illusion8064/analog-kickdrum/hardware/assembled-circuit/full-ckt-breadboard.jpeg

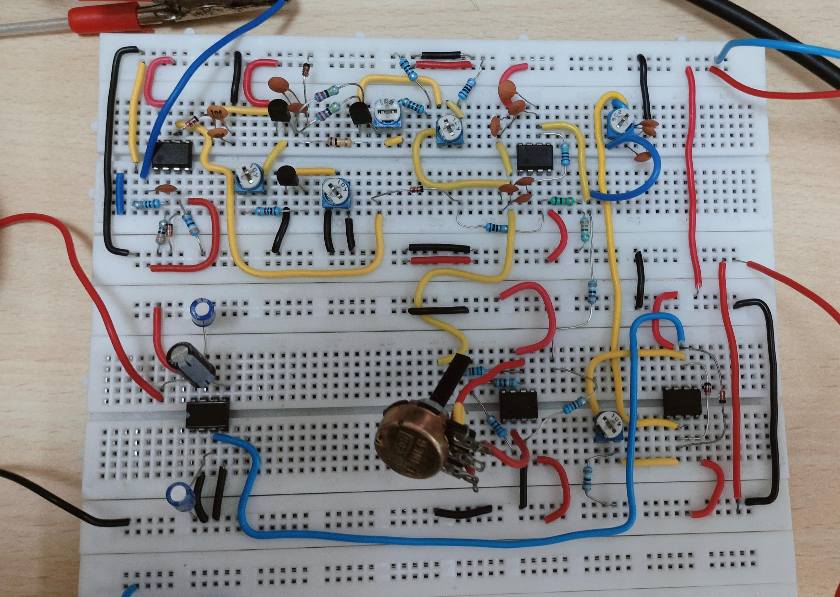
hardware/assembled-circuit/full-ckt-breadboard.jpeg
