illusion8064/analog-kickdrum/hardware/assembled-circuit/envelope.jpeg

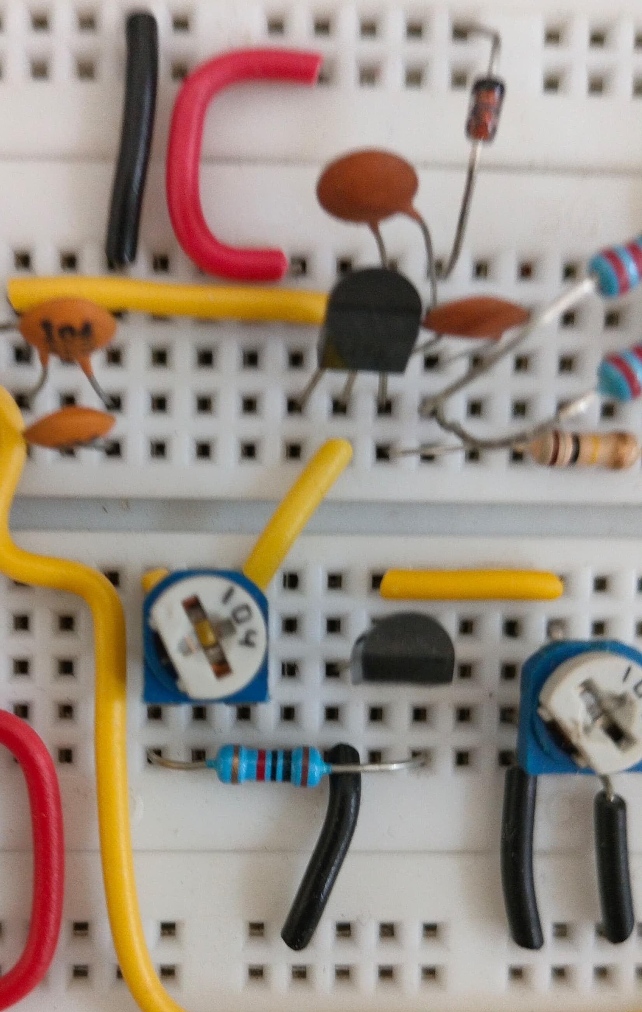
hardware/assembled-circuit/envelope.jpeg
