illusion8064/analog-kickdrum/documents/brief-presentation.pdf

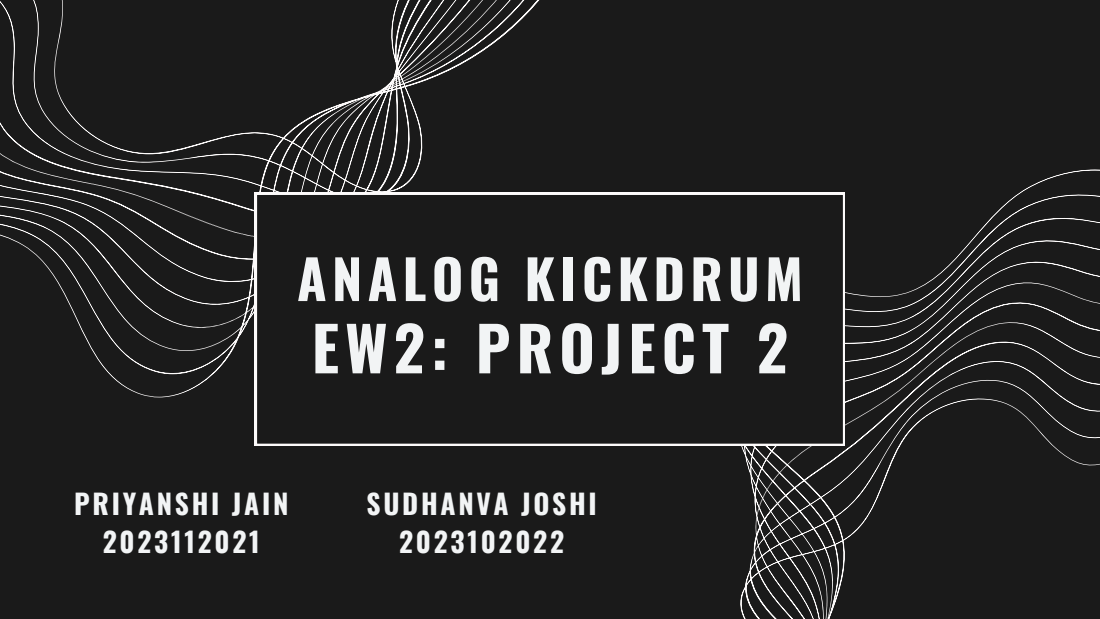
[picture p3: page 1]
EW2: PROJECT 2; ANALOG KICKDRUM; PRIYANSHI JAIN 2023112021; SUDHANVA JOSHI 2023102022

# STAGES

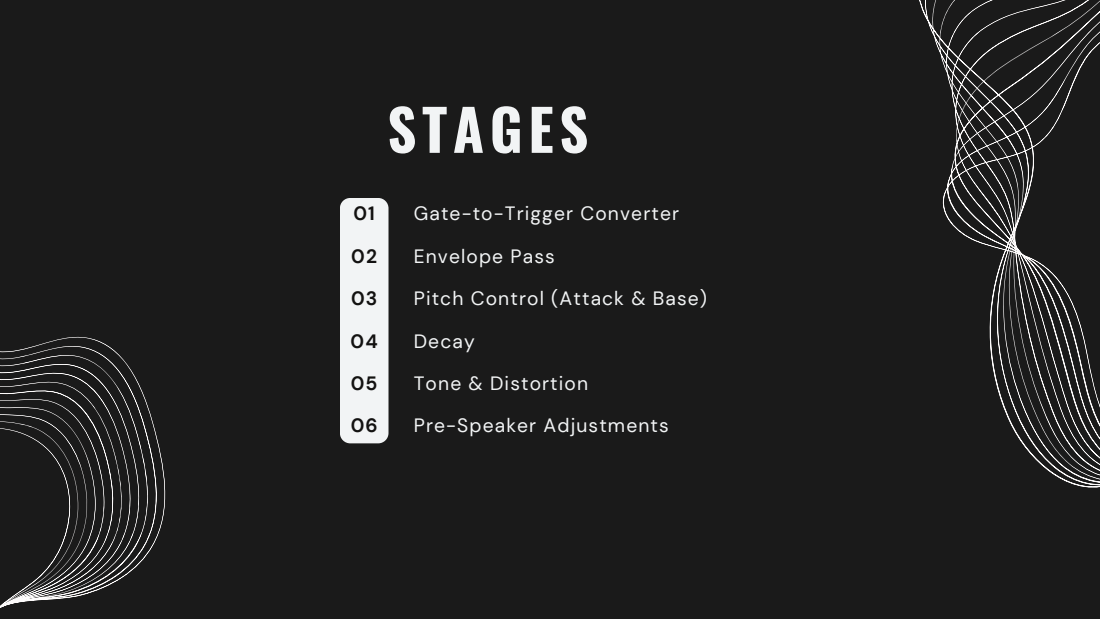
[picture p4: page 2]
Gate-to-Trigger Converter; Envelope Pass; Pitch Control (Attack & Base); Decay; Tone & Distortion; Pre-Speaker Adjustments

# GATE TO TRIGGER CONVERTER

An initial square wave is used to create a
sharp impulse, which will trigger a decaying sinusoid wave for our kickdrum.

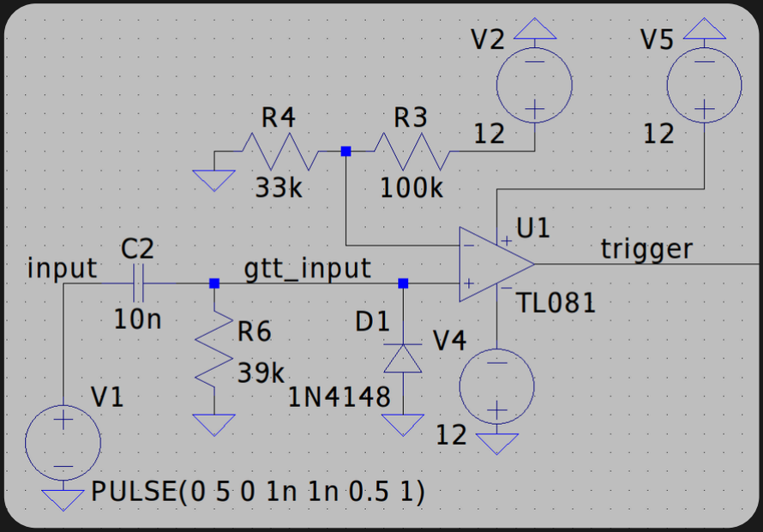
[picture p5: figure]

To only consider the positive impulses formed, we use a comparator which eliminates negative impulses.

As the base voltage of positive impulses is set at -12V, a diode is used to bring it back to set the favourable base voltage of 0V.

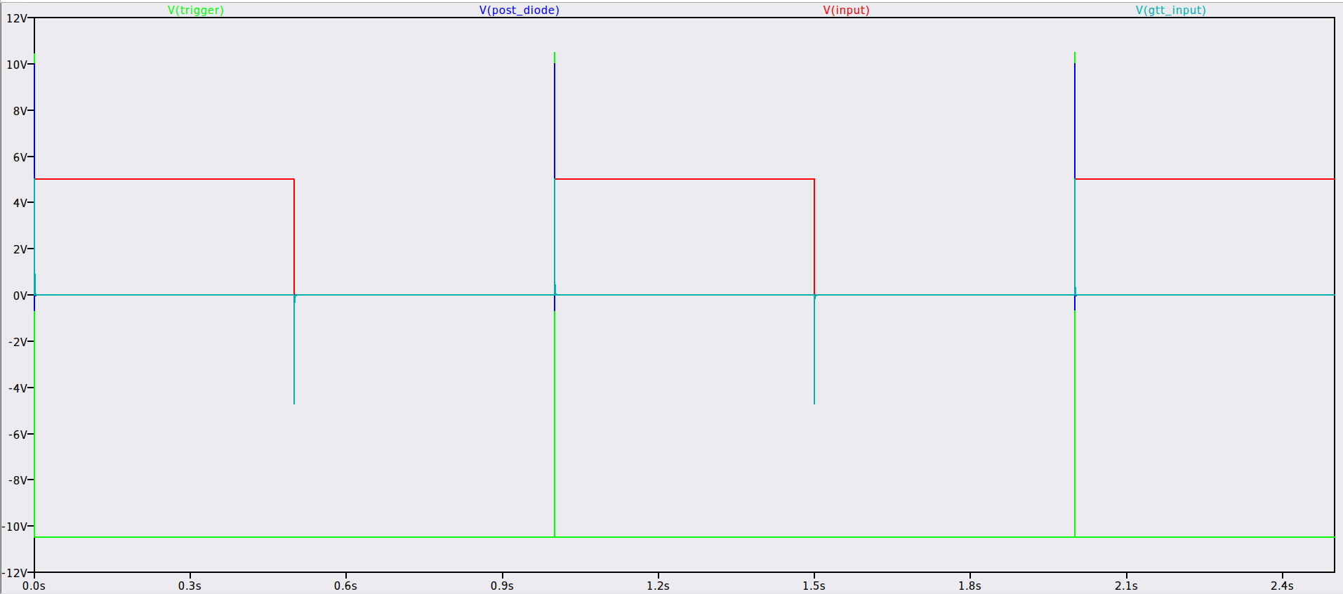
[picture p6: page 4]

# ENVELOPE STAGE

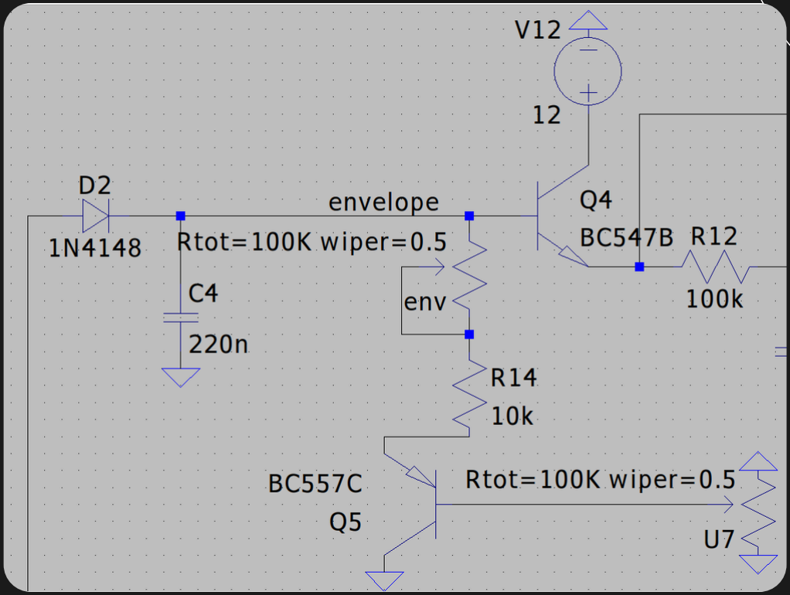
[picture p7: figure]

The envelope controls initial amplitude of our beat wave. This is also used to manipulate attack pitch in later stages.

We induce voltage discharge through a grounded capacitor, and allow rate control using a potentiometer and voltage (grounded and buffered currently).

An NPN BJT is used as a makeshift buffer instead of a bulky op-amp based buffer to prevent discharge path into other stages.

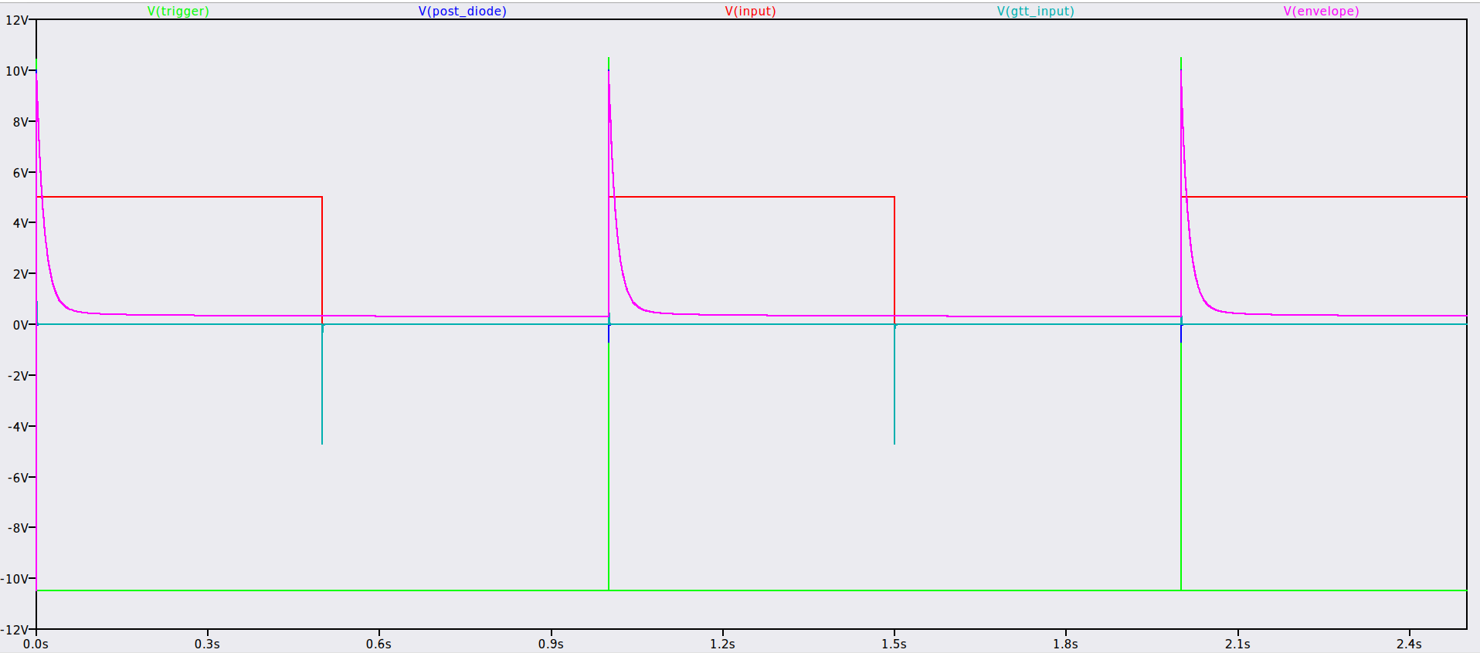
[picture p8: page 6]

# PITCH: BRIDGED-T OSCILLATOR

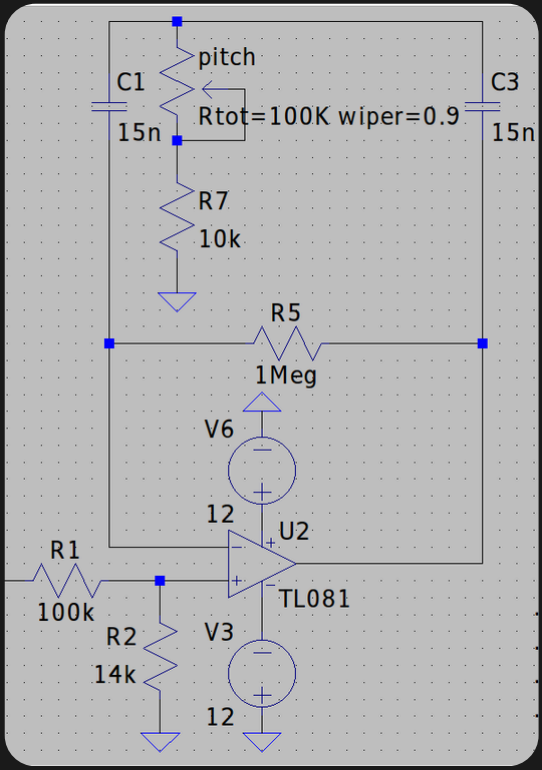
[picture p9: figure]

Pitch affects the frequency of our wave. We
get control over base pitch (f | ) and attack
pitch (f | ).

b a s e

i n iti a l

Initial Voltage Divider drops voltage level for op-amp reception, while potentiometer gives control over capacitor discharge rate.

The Bridge Resistor provides reverse current to the op-amp’s negative feedback for proper amplification, giving a decaying sinusoid.

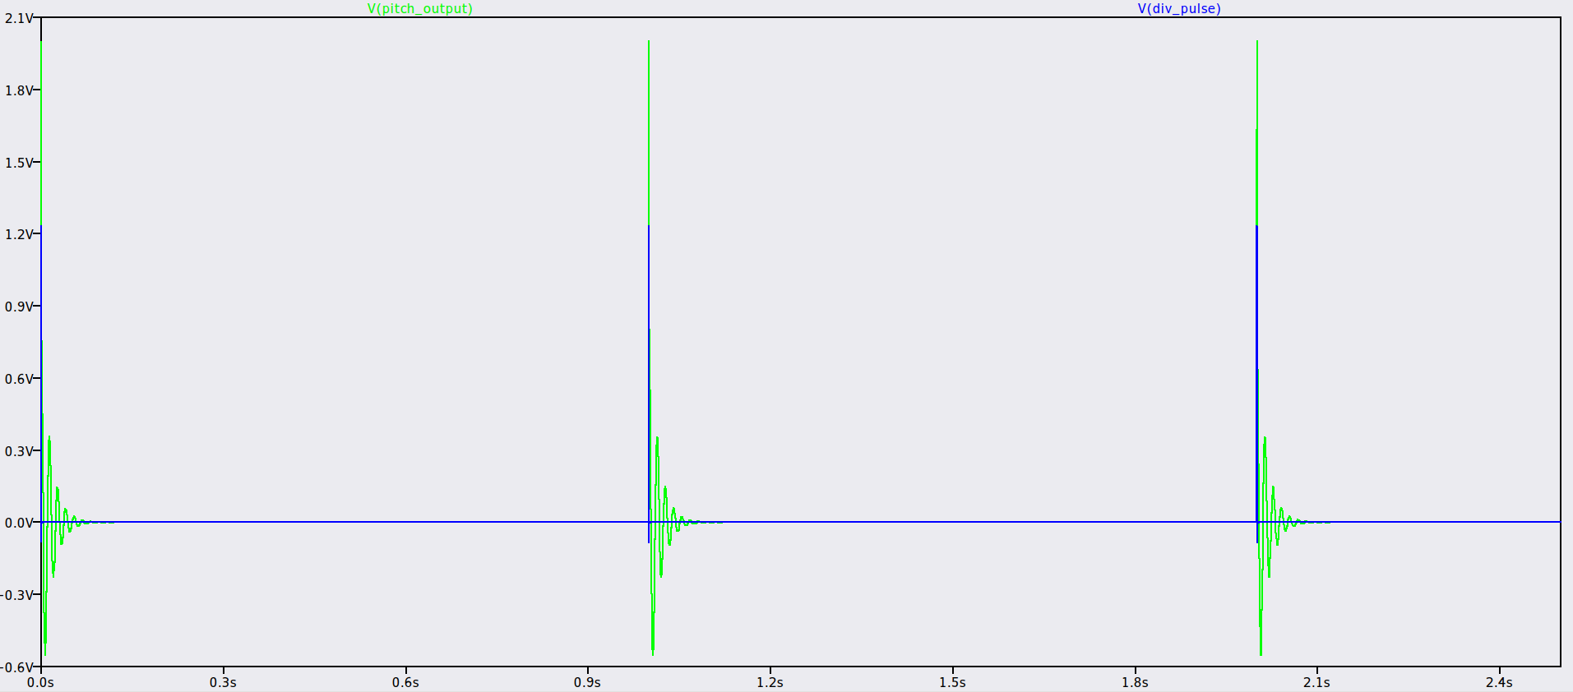
[picture p10: page 8]

# DECAY STAGE

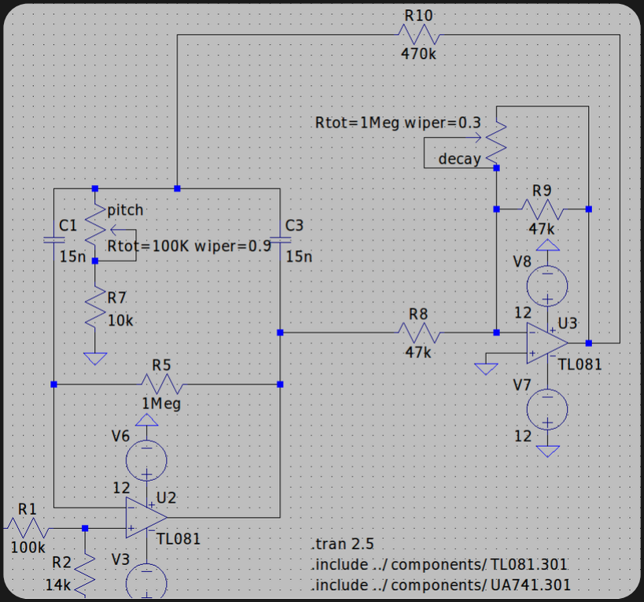
[picture p11: figure]

Decay controls the rate at which our sinusoid dies out.

Initial Voltage Divider drops voltage level for op-amp reception, while potentiometer gives control over capacitor discharge rate.

The Bridge Resistor provides reverse current to the op-amp’s negative feedback for proper amplification, giving a decaying sinuoid.

# TONE & DISTORTION

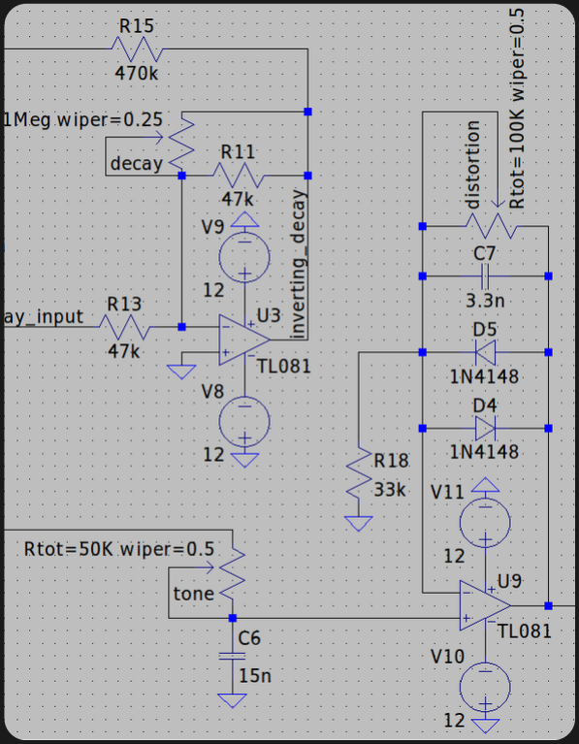
[picture p12: figure]

Tone manipulates the initial amplitude of our waveform, while distortion induces clipping & imperfection in the sinusoid.

An active distortion is induced by pairing 2 diodes, causing clipping and discharging to be controlled by a 100K potentiometer.

Amplitude is controlled using a potentiometer as a variable RC filter.

# FINAL STAGE; LM386 & SPEAKER

Using an LM386N to power our 4Ω speaker, we use a basic op-amp amplifier to attenuate our signal for working around the ±1V cutoff input voltage.

The gain achieved by LM386N is around 20, but the speaker’s impedance reduces voltage peak to favourable levels.

# THANK YOU

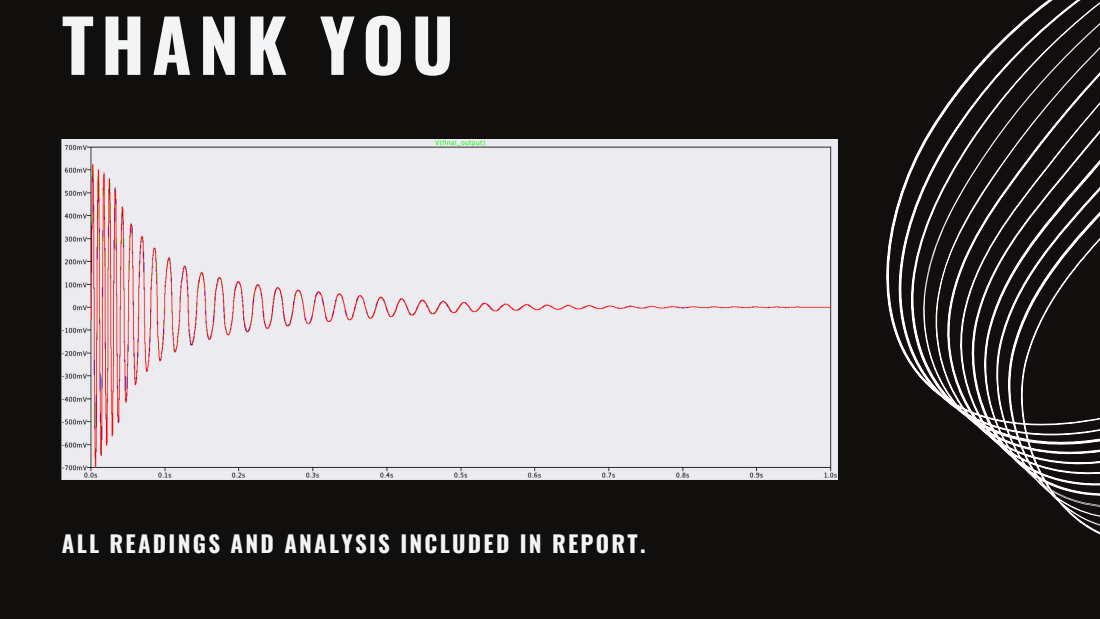
[picture p13: page 12]

ALL READINGS AND ANALYSIS INCLUDED IN REPORT.
