illusion8064/analog-kickdrum/hardware/oscilloscope-outputs/decay-waveform.png

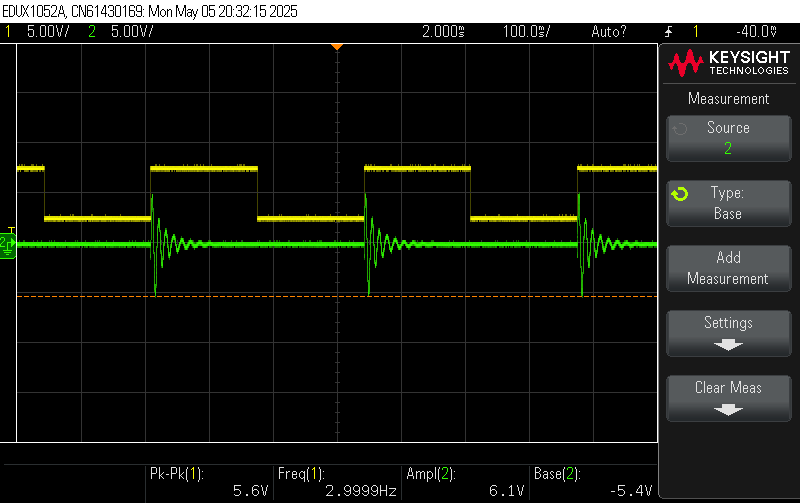
hardware/oscilloscope-outputs/decay-waveform.png
