illusion8064/analog-kickdrum/hardware/oscilloscope-outputs/envelope-waveform.png

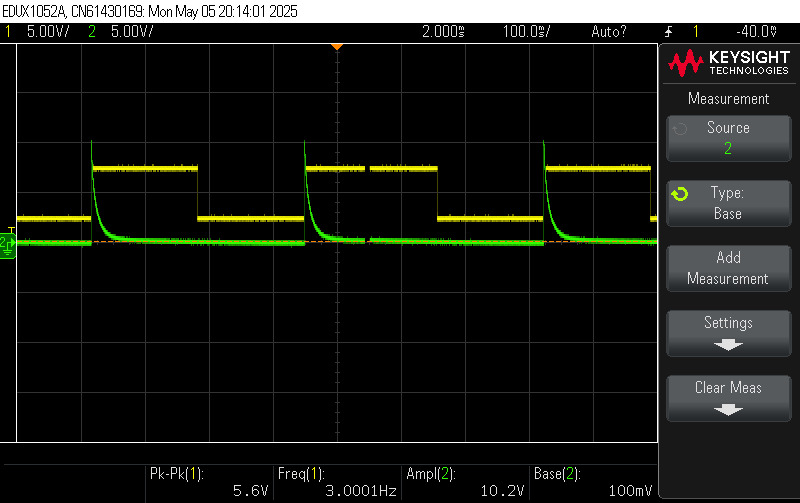
hardware/oscilloscope-outputs/envelope-waveform.png
