illusion8064/analog-kickdrum/hardware/oscilloscope-outputs/final-waveform.png

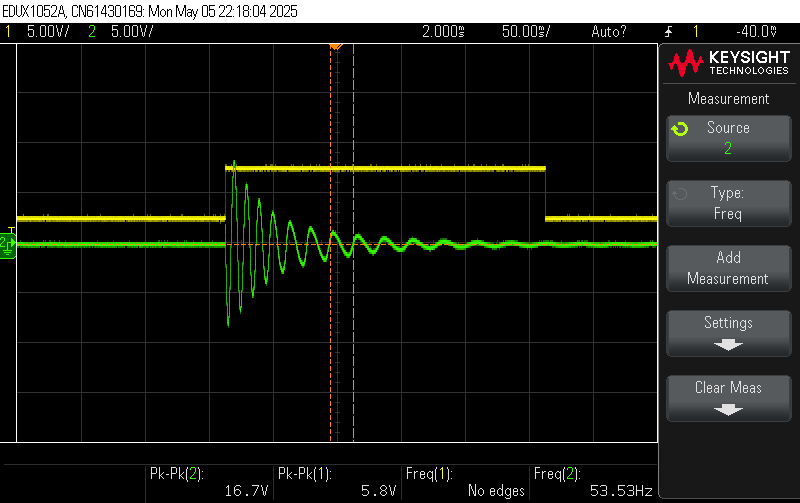
hardware/oscilloscope-outputs/final-waveform.png
