illusion8064/analog-kickdrum/hardware/oscilloscope-outputs/gttprediode-hardware.png

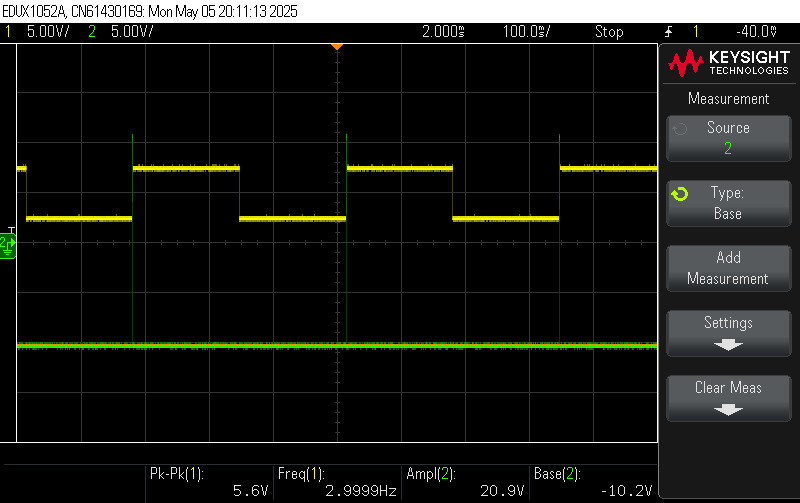
hardware/oscilloscope-outputs/gttprediode-hardware.png
