illusion8064/analog-kickdrum/hardware/oscilloscope-outputs/pitch-waveform.png

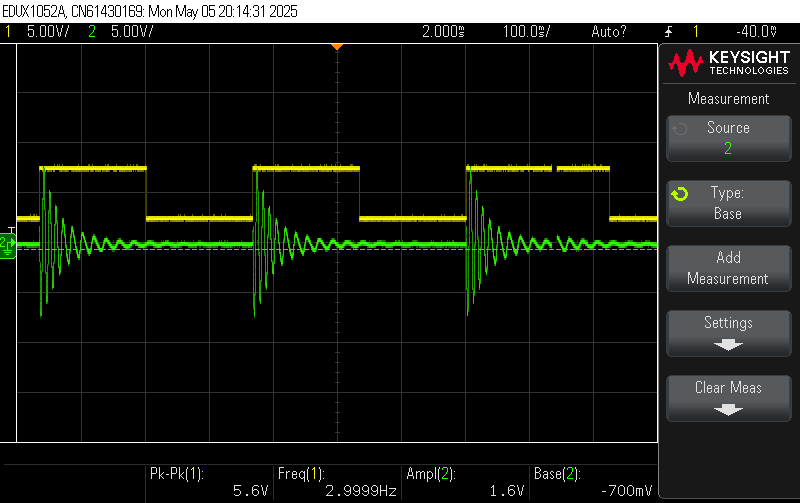
hardware/oscilloscope-outputs/pitch-waveform.png
