illusion8064/analog-kickdrum/hardware/oscilloscope-outputs/tone-waveform.png

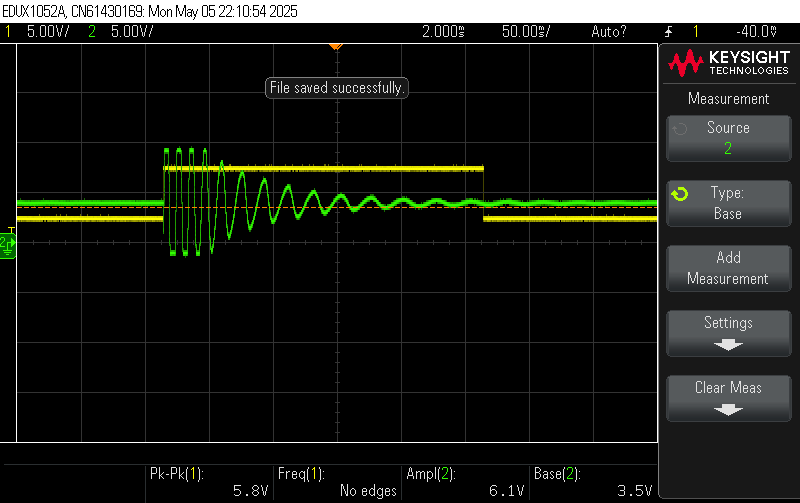
hardware/oscilloscope-outputs/tone-waveform.png
