illusion8064/analog-kickdrum/simulations/final-circuit.png

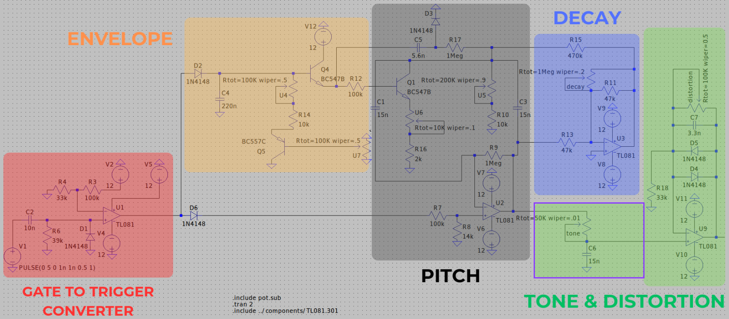
simulations/final-circuit.png
