illusion8064/analog-kickdrum/hardware/bill-of-materials.md

# Bill of Materials

| Ref. | Manufacturer | Part No. | Description |
|---|---|---|---|
| C1 | -- | -- | capacitor, 15nF |
| C2 | -- | -- | capacitor, 10nF |
| C3 | -- | -- | capacitor, 15nF |
| C4 | -- | -- | capacitor, 220nF |
| C5 | -- | -- | capacitor, 5.6nF |
| C6 | -- | -- | capacitor, 3.3nF |
| C7 | -- | -- | capacitor, 3.3nF |
| D1 | OnSemi | 1N4148 | diode |
| D2 | OnSemi | 1N4148 | diode |
| D3 | OnSemi | 1N4148 | diode |
| D4 | OnSemi | 1N4148 | diode |
| D5 | OnSemi | 1N4148 | diode |
| D6 | OnSemi | 1N4148 | diode |
| decay | (unknown) | Rtot=1Meg wiper=0.25 | (unknown 3rd party model) |
| distortion | (unknown) | Rtot=100k wiper=0.3 | (unknown 3rd party model) |
| Q1 | NXP | BC547B | bipolar transistor |
| Q2 | NXP | BC547B | bipolar transistor |
| Q3 | NXP | BC557C | bipolar transistor |
| R1 | -- | -- | resistor, 100K |
| R2 | -- | -- | resistor, 33K |
| R3 | -- | -- | resistor, 100K |
| R4 | -- | -- | resistor, 33K |
| R5 | -- | -- | resistor, 100K |
| R6 | -- | -- | resistor, 1K |
| R7 | -- | -- | resistor, 100K |
| R8 | -- | -- | resistor, 100K |
| R9 | -- | -- | resistor, 47K |
| R10 | -- | -- | resistor, 47K |
| R11 | -- | -- | resistor, 47K |
| R12 | -- | -- | resistor, 100K |
| R13 | -- | -- | resistor, 470K |
| R14 | -- | -- | resistor, 47K |
| R15 | -- | -- | resistor, 1K |
| R16 | -- | -- | resistor, 220K |
| R17 | -- | -- | resistor, 470K |
| R18 | -- | -- | resistor, 33K |
| R19 | -- | -- | resistor, 2.2K |
| R20 | -- | -- | resistor, 10K |
| tone | (unknown) | Rtot=50K wiper=0.1  | (unknown 3rd party model) |
| U1 | (unknown) | TL081 | (unknown 3rd party model) |
| U2 | (unknown) | TL081 | (unknown 3rd party model) |
| U3 | (unknown) | TL081 | (unknown 3rd party model) |
| U4 | (unknown) | Rtot=100k wiper=0.9 | (unknown 3rd party model) |
| U5 | (unknown) | Rtot=200K wiper=0.9 | (unknown 3rd party model) |
| U6 | (unknown) | Rtot=10K wiper=0.5  | (unknown 3rd party model) |
| U7 | (unknown) | Rtot=100K wiper=0.5 | (unknown 3rd party model) |
| U9 | (unknown) | TL081 | (unknown 3rd party model) |
