illusion8064/analog-kickdrum/simulations/spice-files/decay.asc

C1: cap; 15n
C2: cap; 10n
C3: cap; 15n
D1: diode; 1N4148
D2: diode; 1N4148
decay: pot; Rtot=1Meg wiper=0.3
pitch: pot; Rtot=100K wiper=0.9
R1: res; 100k
R2: res; 14k
R3: res; 100k
R4: res; 33k
R5: res; 1Meg
R6: res; 39k
R7: res; 10k
R8: res; 47k
R9: res; 47k
R10: res; 470k
U1: opamp2; TL081
U2: opamp2; TL081
U3: opamp2; TL081
V1: voltage; PULSE(0 5 0 1n 1n 0.5 1)
V2: voltage; 12
V3: voltage; 12
V4: voltage; 12
V5: voltage; 12
V6: voltage; 12
V7: voltage; 12
V8: voltage; 12
Named nets: 0
.tran 2.5
.include ../components/UA741.301
.include ../components/TL081.301
.include pot.sub
