illusion8064/analog-kickdrum/simulations/spice-files/kickdrum.asc

C1: cap; 15n
C2: cap; 10n
C3: cap; 15n
C4: cap; 220n
C5: cap; 5.6n
C6: cap; 15n
C7: cap; 3.3n
cv: voltage; 5
D1: diode; 1N4148
D2: diode; 1N4148
D3: diode; 1N4148
D4: diode; 1N4148
D5: diode; 1N4148
D6: diode; 1N4148
decay: pot; Rtot=1Meg wiper=.2
distortion: pot; Rtot=100K wiper=0.5
Q1: npn; BC547B
Q2: pnp; BC557C
Q3: npn; BC547B
Q4: npn; BC547B
Q5: pnp; BC557C
R1: res; 100k
R2: res; 22k
R3: res; 100k
R4: res; 33k
R5: res; 120k
R6: res; 39k
R7: res; 100k
R8: res; 14k
R9: res; 1Meg
R10: res; 10k
R11: res; 47k
R12: res; 100k
R13: res; 47k
R14: res; 10k
R15: res; 470k
R16: res; 2k
R17: res; 1Meg
R18: res; 33k
tone: pot; Rtot=50K wiper=.01
U1: opamp2; TL081
U2: opamp2; TL081
U3: opamp2; TL081
U4: pot; Rtot=100K wiper=.5
U5: pot; Rtot=200K wiper=.9
U6: pot; Rtot=10K wiper=.1
U7: pot; Rtot=100K wiper=.5
U9: opamp2; TL081
V1: voltage; PULSE(0 5 0 1n 1n 0.5 1)
V2: voltage; 12
V3: voltage; 12
V4: voltage; 12
V5: voltage; 12
V6: voltage; 12
V7: voltage; 12
V8: voltage; 12
V9: voltage; 12
V10: voltage; 12
V11: voltage; 12
V12: voltage; 12
Named nets: 0
.tran 2
.include ../components/UA741.301
.include ../components/TL081.301
.include pot.sub
