illusion8064/analog-kickdrum/hardware/assembled-circuit/decay.jpeg

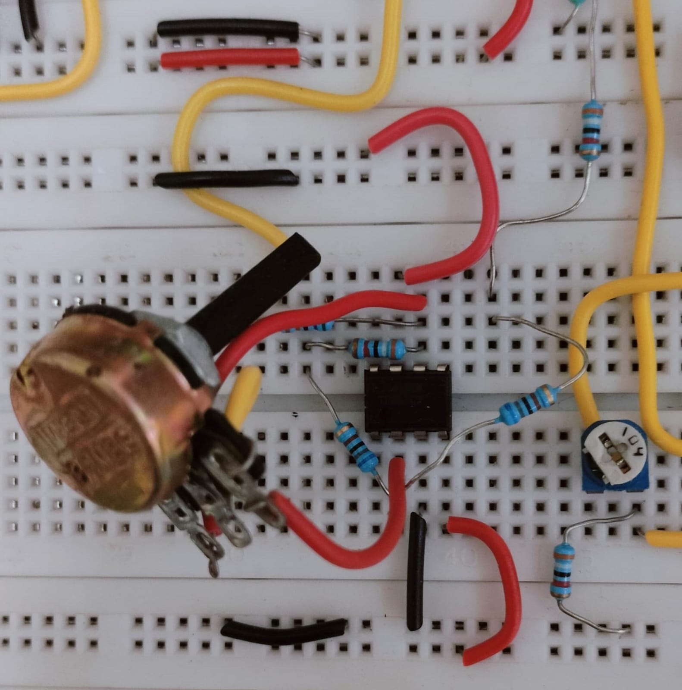
hardware/assembled-circuit/decay.jpeg
