illusion8064/analog-kickdrum/hardware/assembled-circuit/full-ckt.png

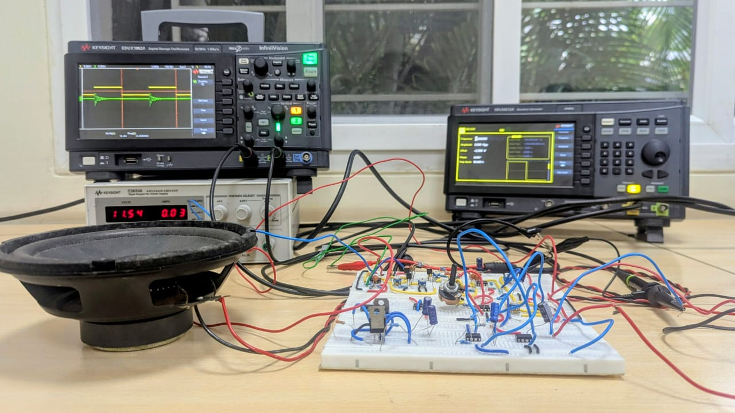
hardware/assembled-circuit/full-ckt.png
