illusion8064/analog-kickdrum/hardware/assembled-circuit/gttc.jpeg

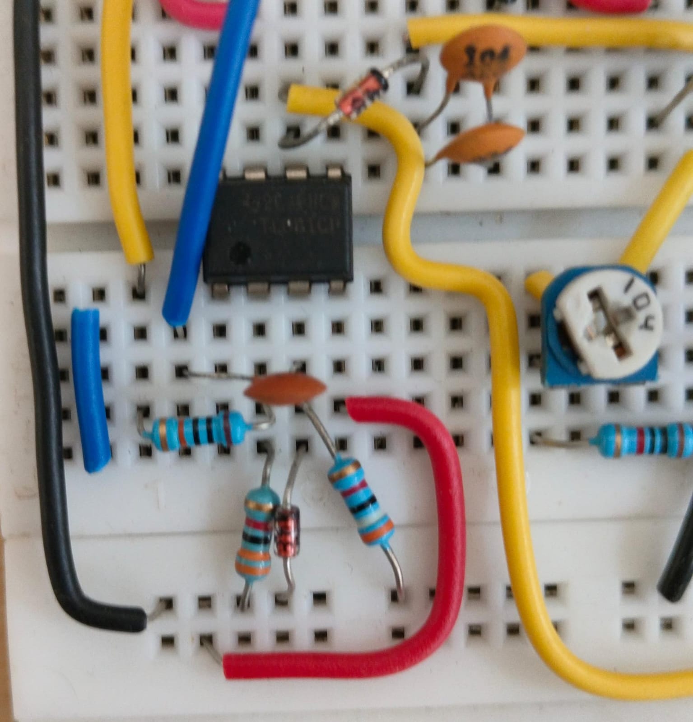
hardware/assembled-circuit/gttc.jpeg
