illusion8064/analog-kickdrum/hardware/assembled-circuit/pitch.jpeg

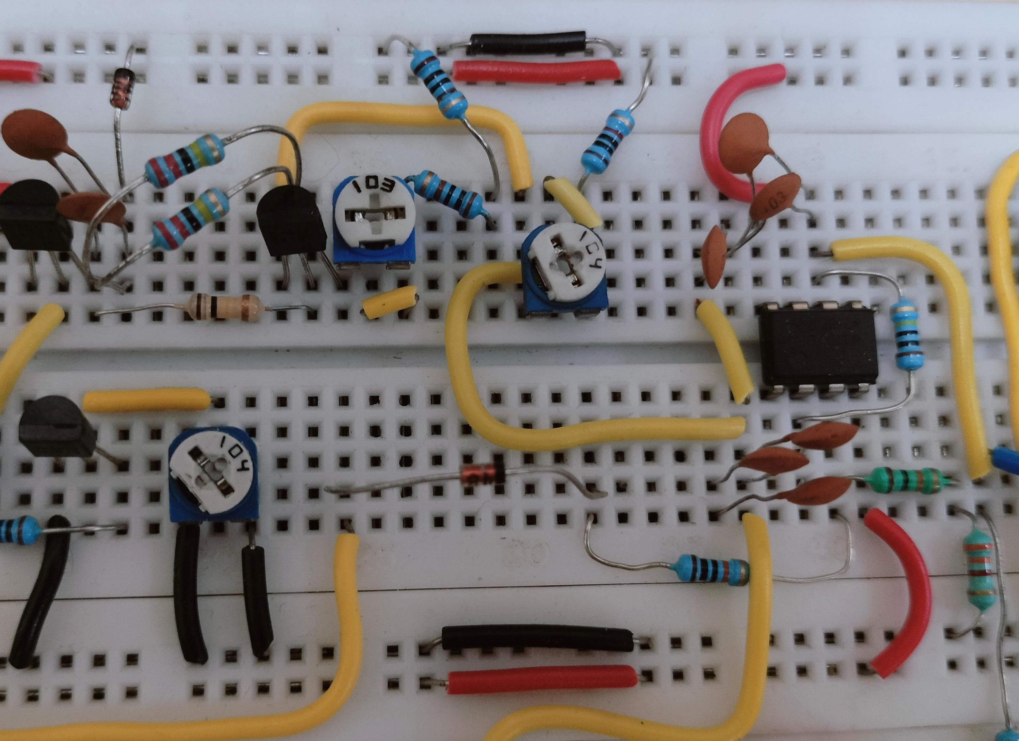
hardware/assembled-circuit/pitch.jpeg
