illusion8064/analog-kickdrum/hardware/assembled-circuit/tone-distortion.jpeg

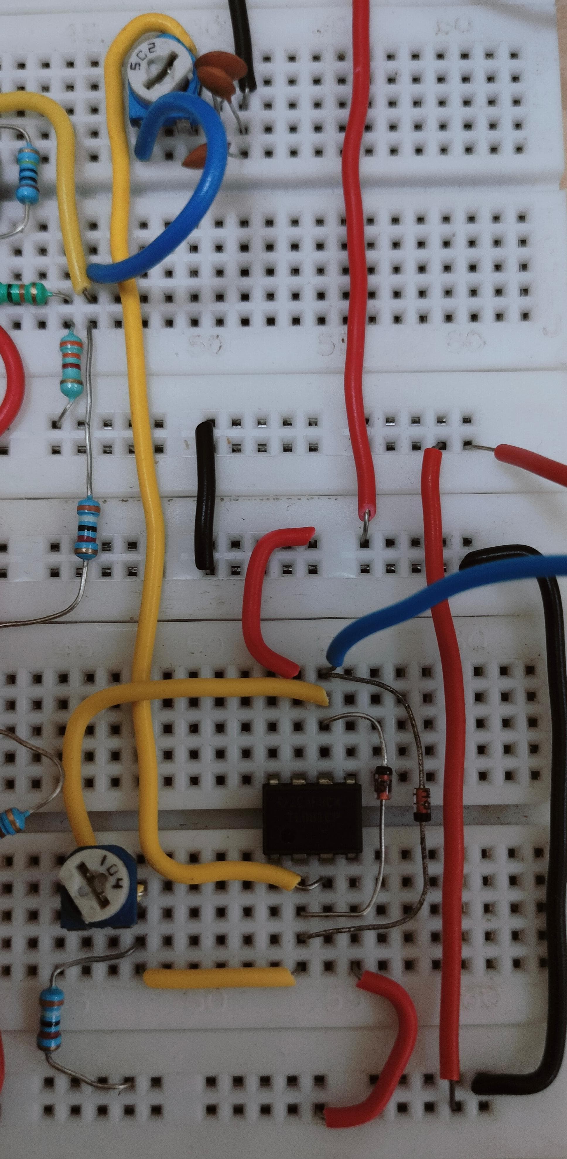
hardware/assembled-circuit/tone-distortion.jpeg
